marekw1986/Kobalt182/code/CPMBootloader/README.md

# POLON 7880

This is code of TinyBsic for final version of POLON 7880, build on PCBs.
