marekw1986/Kobalt182/(commit log)

2025-05-30 PCB updated
    [untitled.brd, untitled.sch]
2025-06-06 PCB project updated (work in progress)
    [untitled.brd, untitled.sch]
2025-06-06 PBC project updated (work in progress)
    [untitled.brd, untitled.sch]
2025-06-06 PCB update (work in progress)
    [untitled.brd]
2025-06-06 PCB update
    [untitled.brd]
2025-06-07 Minor update in PCB design
    [untitled.brd, untitled.sch]
2025-06-08 Minor fix
    [untitled.brd]
2025-06-08 PCB updated - data lines routed (work in progress)
    [untitled.brd]
2025-06-09 PCB project update (work in progress)
    [untitled.brd, untitled.sch]
2025-06-09 CF card socket added (work in progress)
    [untitled.brd, untitled.sch]
2025-06-11 PCB update - I/O address decoder added (work in progress)
    [untitled.brd, untitled.sch]
2025-06-11 Minor PCB update (work in progress)
    [untitled.brd, untitled.sch]
2025-06-11 CPU board update (work in progress)
    [untitled.brd, untitled.sch]
2025-06-13 Minor changes in PCB design
    [untitled.brd, untitled.sch]
2025-06-13 PCB edit (work in progress)
    [untitled.brd]
2025-06-15 PCB design updated. NMI, WAIT, BUSREQ and BUSACK signals routed to additional connector
    [untitled.brd, untitled.sch]
2025-06-16 Resistor network added
    [untitled.brd, untitled.sch]
2025-06-17 Pullup resistors added
    [untitled.brd, untitled.sch]
2025-06-17 I/O address decoder adjusted to internal registers of Z80182
    [untitled.brd, untitled.sch]
2025-06-19 Reset supervisor added, GND tracing changed
    [untitled.brd, untitled.sch]
2025-06-19 Reset circuit updated
    [untitled.brd, untitled.sch]
2025-06-19 Connector instead LED on board
    [untitled.brd, untitled.sch]
2025-06-22 Power circuit updated
    [untitled.brd, untitled.sch]
2025-06-29 Printer port (work in progress)
    [untitled.brd, untitled.sch]
2025-06-30 Buffer added on printer port data lines
    [untitled.brd, untitled.sch]
2025-07-01 Minor change on PCB
    [untitled.brd]
2025-07-01 Another buffer added to printer port
    [untitled.brd, untitled.sch]
2025-07-03 Power trace updated
    [untitled.brd, untitled.sch]
2025-07-03 Additional printer traces routed
    [untitled.brd, untitled.sch]
2025-07-04 VCC rerouted
    [untitled.brd]
2025-07-04 Printer port wired
    [untitled.brd, untitled.sch]
2025-07-04 Printer error line routed
    [untitled.brd, untitled.sch]
2025-07-04 Capacitors added
    [untitled.brd, untitled.sch]
2025-07-04 Minor changes
    [untitled.brd]
2025-07-04 Mounting holes added, board size adjusted
    [untitled.brd]
2025-07-05 Dangling signals fixed
    [untitled.brd, untitled.sch]
2025-07-05 ST signal connected (work in progress)
    [untitled.brd, untitled.sch]
2025-07-06 Pull-up on ST and DREQ lines added
    [untitled.brd, untitled.sch]
2025-07-07 Debug LED added
    [untitled.brd, untitled.sch]
2025-07-08 GND and VCC pins removed from bottom bus connector to prevent GND loop
    [untitled.brd, untitled.sch]
2025-08-01 Bug in hardware design fixed - CF card address moved, upper I/O addreses not used due to conflict with internal registers
    [untitled.brd, untitled.sch]
2025-08-01 Crystal resonator replaced with crystal generator
    [untitled.brd, untitled.sch]
2025-08-26 blink and test uart added
2025-09-05 Config changes in test_uart t oenable RTSA pin
2025-09-11 MVI A, 00H replaced with XOR A to preserve memory and CPU cycles
    [test_uart.asm]
2025-09-11 Revert "MVI A, 00H replaced with XOR A to preserve memory and CPU cycles"
    This reverts commit 5c4637fd88a033c001f39b4de0042432ee14601f.
    [test_uart.asm]
2025-09-11 MVI A, 00H replaced with XRA A
    [test_uart.asm]
2025-09-13 Fixed in blink_stack, Z180 version prepared
    [utils_z180.asm]
2025-09-16 UART works
2025-09-17 PCB updated - resistors protecting default output lines at reset
    [untitled.brd, untitled.sch]
2025-09-17 DREQ0 disconnected from common pull-up with DREQ1 because default function of this pin is CKA0
    [untitled.brd, untitled.sch]
2025-09-21 Deffered writes bug fixed
    [bios_z180.asm]
2025-09-22 Flushing deferred writes in case of CALC_CFLBA_FROM_PART_ADR fail
    [bios_z180.asm, cf_z180.asm]
2025-09-22 Temporary workaround for deffered write issue
    [bios_z180.asm]
2025-11-10 NOP added after UART initialization
2025-11-10 PCB fix
    [untitled.brd, untitled.sch]
2025-11-10 Slight optimization of PCB
    [untitled.brd]
2025-11-13 Curout added to avoiding accidental shorting of DB9 socket shield to board ground
    [untitled.brd]
2025-11-13 Version of board with regular crystal instead of oscilator added
    [untitled.brd, untitled.sch]
